sailingharry/Fog-Horn-Control/README.md

# Fog-Horn-Control
Control fog horn on pleasure vessels
Docx file provides details
ino file is ESP32 program
apk file is Android control program
stl files are box and lid for 3D printing
