sailingharry/Fog-Horn-Control/ESP Box.stl

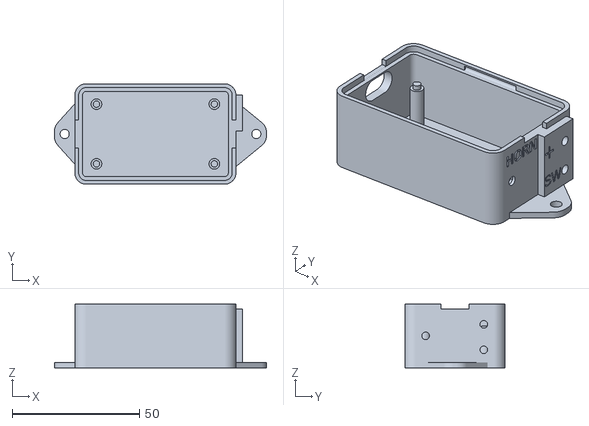
[picture p7: CAD file, 2025-07-13]
ESP Box.stl
83.4 x 39.5 x 25.0
